dakloifarwa/etoasi/README.md

# etoasi
ETOASI is an adapter to connect Sony E-mount lenses to ASI cameras by ZWO Optical.
