dakloifarwa/etoasi/CAM Files/backholder.stl

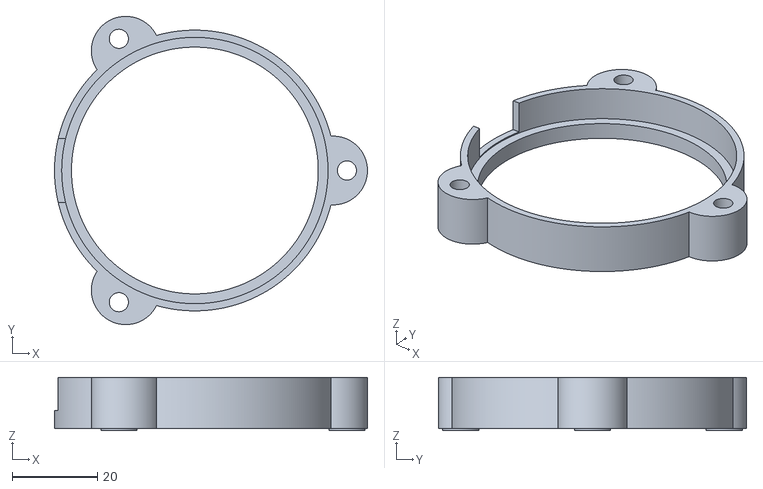
[picture p1: CAD file, 2020-02-02]
CAM Files/backholder.stl
73.6 x 72.5 x 12.5
