dakloifarwa/etoasi/(threads)

Thread 3 (2017-06-07):

Verkippungskorrektur?

DKF-Engineering, 2017-06-07:
Eventuell drei Bohrungen für Madenschrauben M3 in die Stirnfläche integrieren, um die Verkippung der Kamera beim Befestigen kontrollieren zu können

DKF-Engineering, 2017-06-08:
Nur schwer möglich, da Referenzfläche zu schmal

Closed 2017-06-08.

Thread 5 (2017-06-08):

Streulichtproblem

DKF-Engineering, 2017-06-08:
Seitlich gelangt Streulicht in die Kamera.
Ausserdem sollte das Material geschwärzt sein.

DKF-Engineering, 2017-06-08:
Erste Maßnahme: Adapter sollte die Kamera seitlich um 1-2mm überlappen.

DKF-Engineering, 2017-06-08:
Und schwarze (oder Metall-) Rändelschrauben verwenden

DKF-Engineering, 2017-06-08:
Konstruktion erledigt!

Closed 2017-06-08.

Thread 6 (2017-09-23):

Klemmung verbessern

dakloifarwa, 2017-09-23:
Die Klemmung mit 3 Kunststoff-Rändelschrauben ist zwar für die Bedienung recht komfortabel, jedoch ist die Auflagefläche der Schrauben zu rund. Dadurch hebt und senkt sich der Adapter unbestimmt beim Festklemmen an die Kamera.
Lösungsansätze:
1. Madenschrauben zum einmaligen Festklemmen
2. Rändelschrauben aus Metall mit definierter Spitze
3. Klemmen per Ring bzw. Zwischenplättchen unter der Schraube, um Anpressdruck gleichmäßig zu verteilen

Closed 2018-11-15.
