dakloifarwa/etoasi/(commit log)

2017-05-15 CHG: License type CHG: Added source files
    [etoasi.scad]
2017-06-07 CHG: neue Version mit 3 Klemmschrauben
    [etoasi.scad]
2017-06-08 BUG: diverse Bugs geschlossen, s. Issues unter Github
    [etoasi.scad, etoasi.stl]
2018-01-13 NEW: additional backholder to maintain the focus position
    [backholder.stl, etoasi.scad, etoasi.stl]
2018-11-15 CHG: Version 1.4 mit verstärktem Ring
    [backholder.stl, etoasi.scad]
2020-02-02 BUG: increased the thickness to avoid bending
    [backholder.stl, etoasi.scad]
